ImperialCollegeLondon/openFrame/openFrame CAD/OF-HA-AC-00.stp

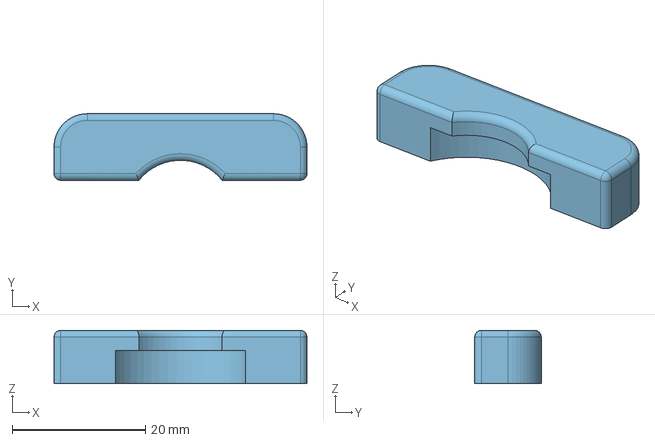
[picture p1: CAD file, 2023-07-18]
openFrame CAD/OF-HA-AC-00.stp
38.0 x 10.00 x 8.00 mm
