ImperialCollegeLondon/openFrame/openFrame part description PDFs/OF-HA-AC-00.pdf

# Dimensions in mm unless otherwise specified Tolerances equal +/- 0.05mm

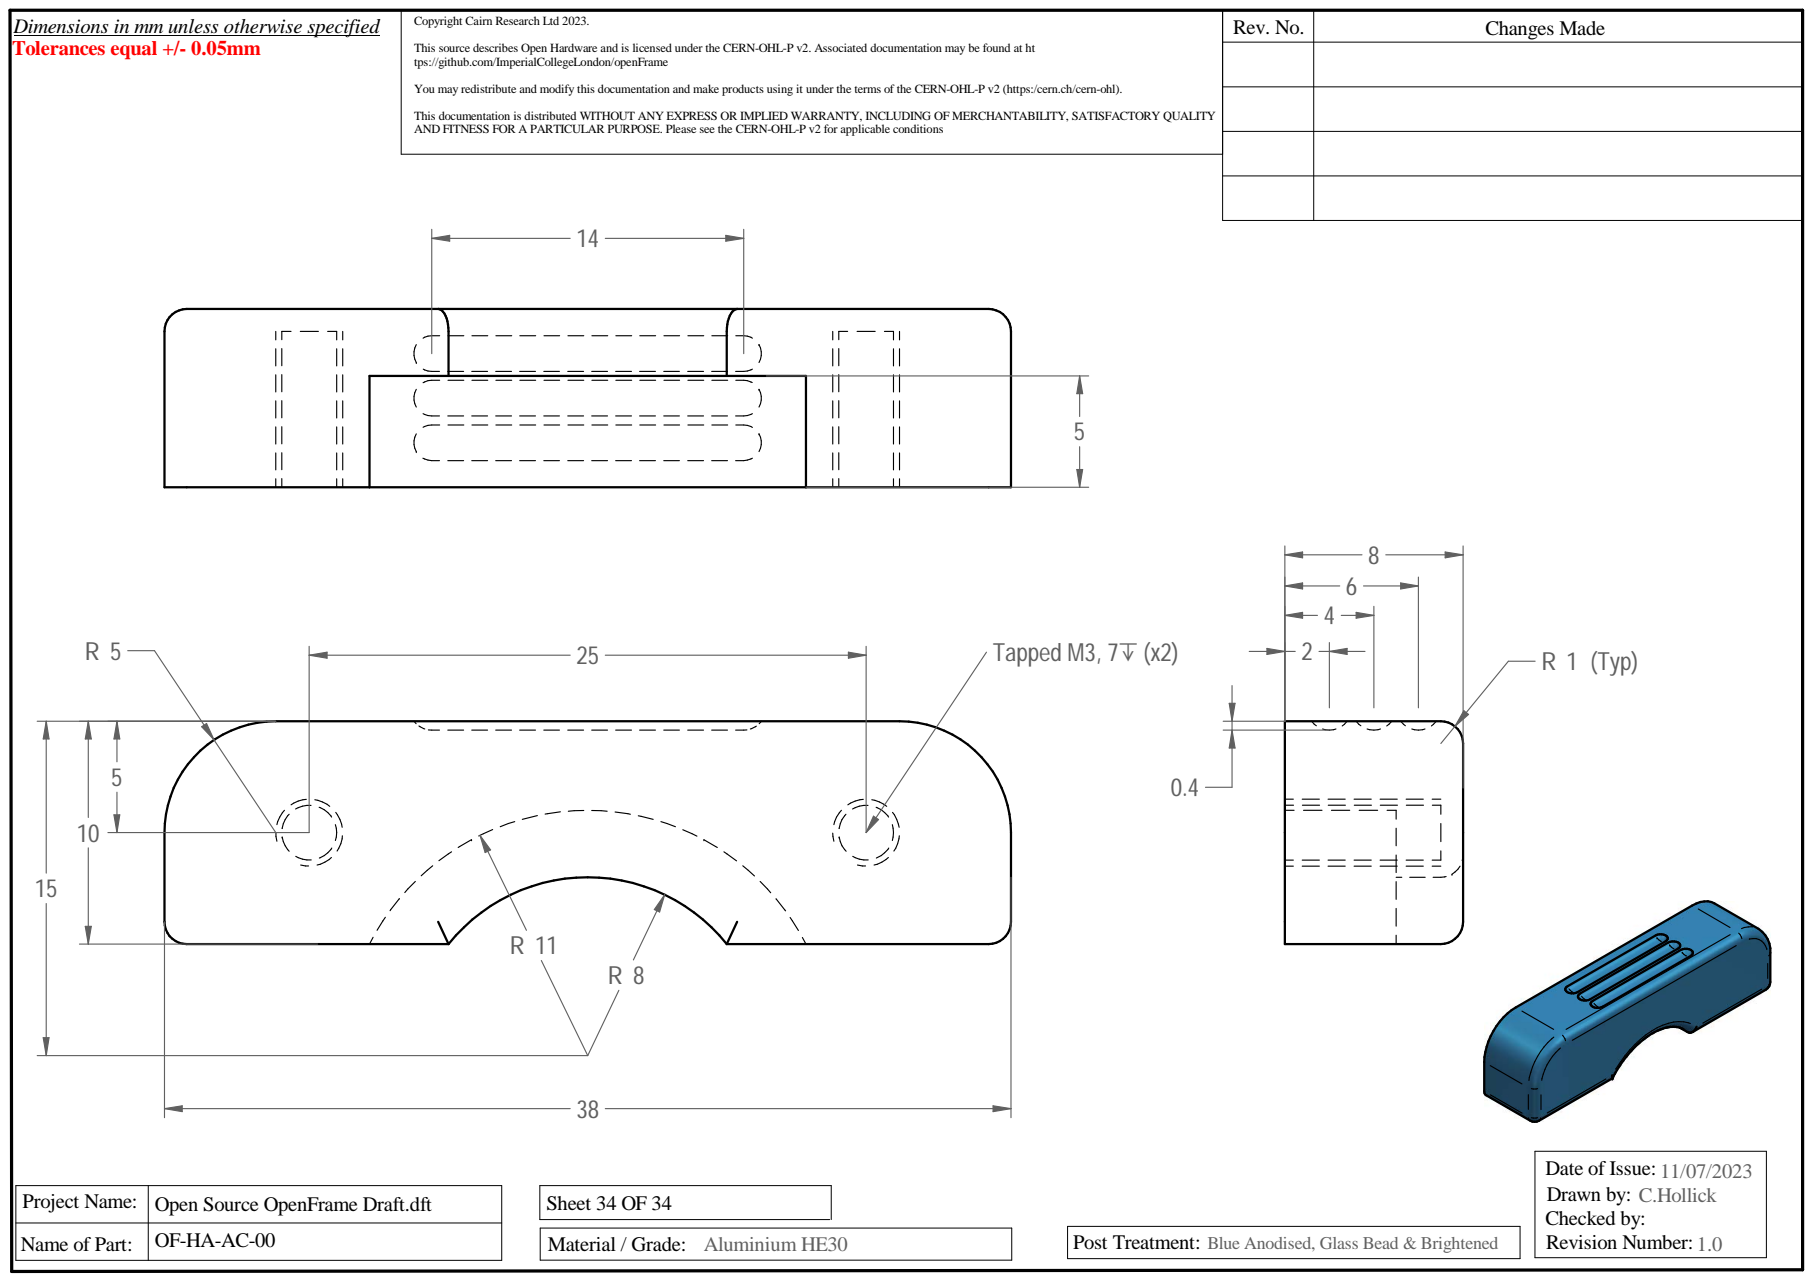
[picture p1: page 1]
Project Name:; Material / Grade:; Post Treatment:; Open Source OpenFrame Draft.dft; Sheet 34 OF 34; Rev. No.; Changes Made Copyright Cairn Research Ltd 2023.; Tapped M3, 7` (x2); R 1 (Typ) 25; Aluminium HE30; Blue Anodised, Glass Bead & Brightened; C.Hollick

This source describes Open Hardware and is licensed under the CERN-OHL-P v2. Associated documentation may be found at ht
tps://github.com/ImperialCollegeLondon/openFrame

You may redistribute and modify this documentation and make products using it under the terms of the CERN-OHL-P v2 (https:/cern.ch/cern-ohl).

This documentation is distributed WITHOUT ANY EXPRESS OR IMPLIED WARRANTY, INCLUDING OF MERCHANTABILITY, SATISFACTORY QUALITY
AND FITNESS FOR A PARTICULAR PURPOSE. Please see the CERN-OHL-P v2 for applicable conditions

Date of Issue:
Drawn by:
Checked by:
Revision Number:

Name of Part:
