ImperialCollegeLondon/openFrame/(notices)

Notices in the files:
openFrame CAD/OF-HA-AC-00.stp:
Copyright Cairn Research and Imperial College London 2023.
This source describes Open Hardware and is licensed under
the CERN-OHL-P v2. Associated documentation may be found at
using it under the terms of the CERN-OHL-P v2
(https:/cern.ch/cern-ohl).
